Susensio/soft-starter/docs/photos/IMG_20240419_203253329.jpg

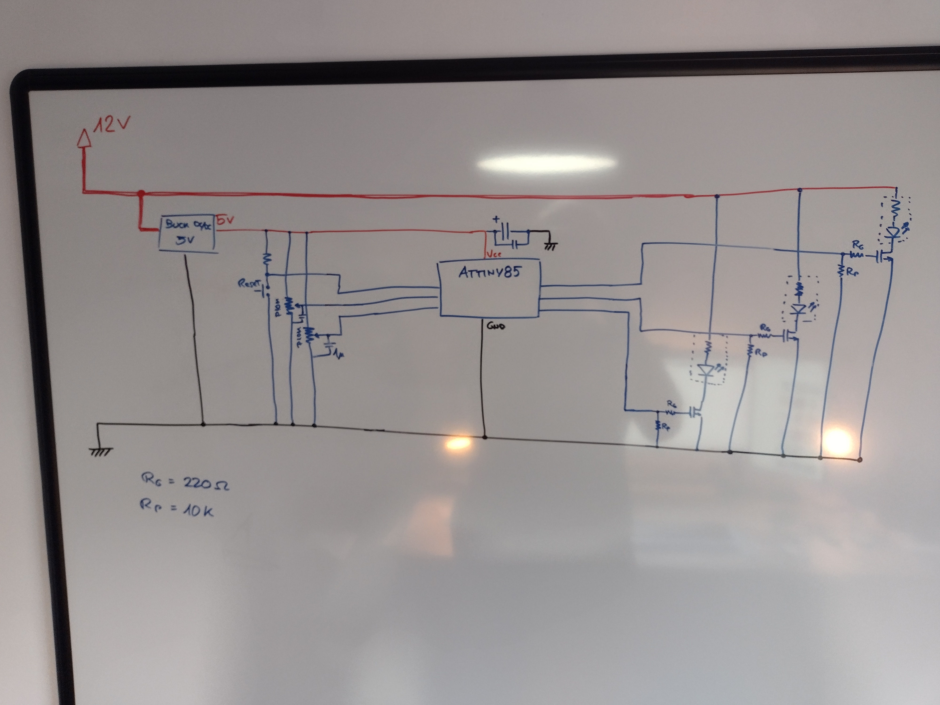
docs/photos/IMG_20240419_203253329.jpg
