Susensio/soft-starter/docs/photos/IMG_20240422_180927953.jpg

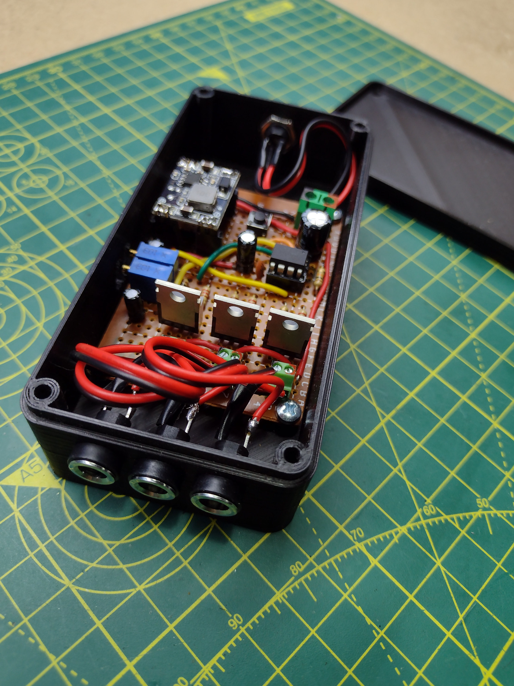
docs/photos/IMG_20240422_180927953.jpg
