Susensio/soft-starter/docs/photos/IMG_20240419_124029173.jpg

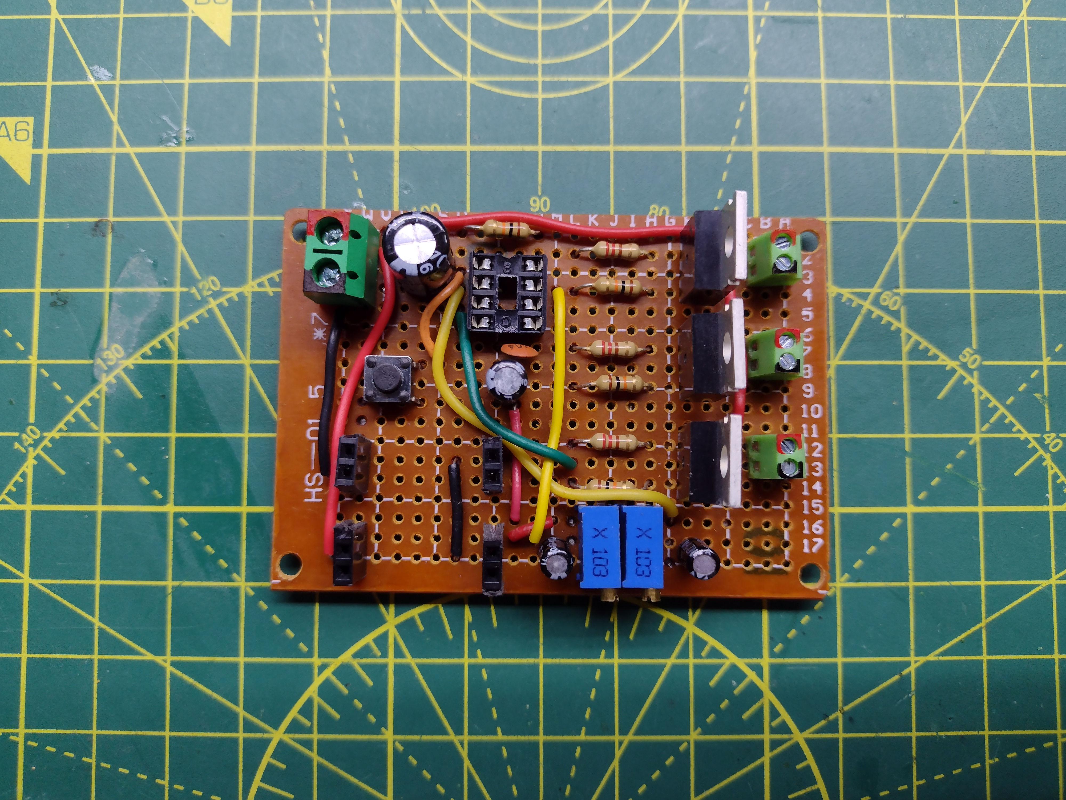
docs/photos/IMG_20240419_124029173.jpg
