Susensio/soft-starter/docs/photos/IMG_20240419_124034786.jpg

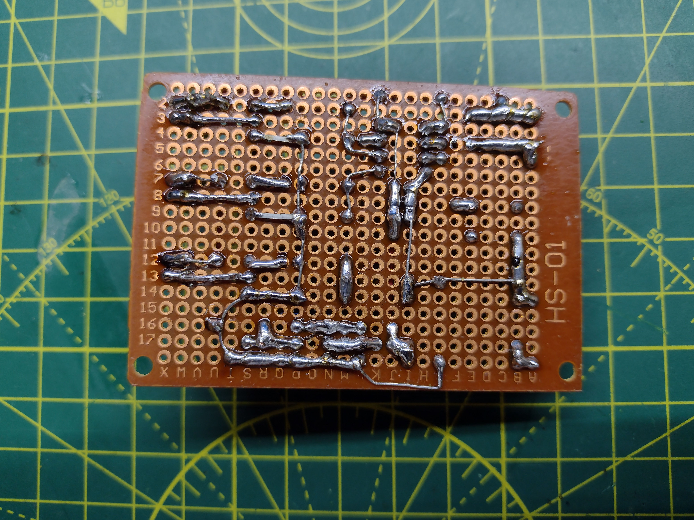
docs/photos/IMG_20240419_124034786.jpg
