Susensio/soft-starter/enclosure/soft_starter_box.stl

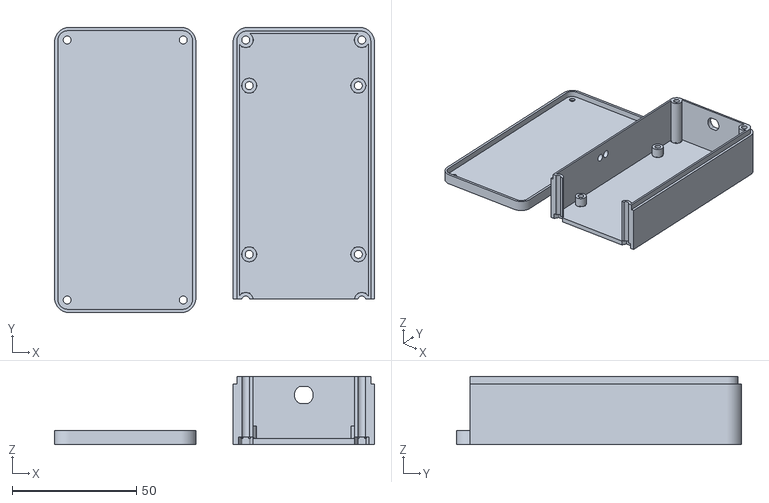
[picture p5: CAD file, 2024-04-25]
enclosure/soft_starter_box.stl
129.0 x 115.0 x 27.5
