Susensio/soft-starter/docs/schematics.pdf

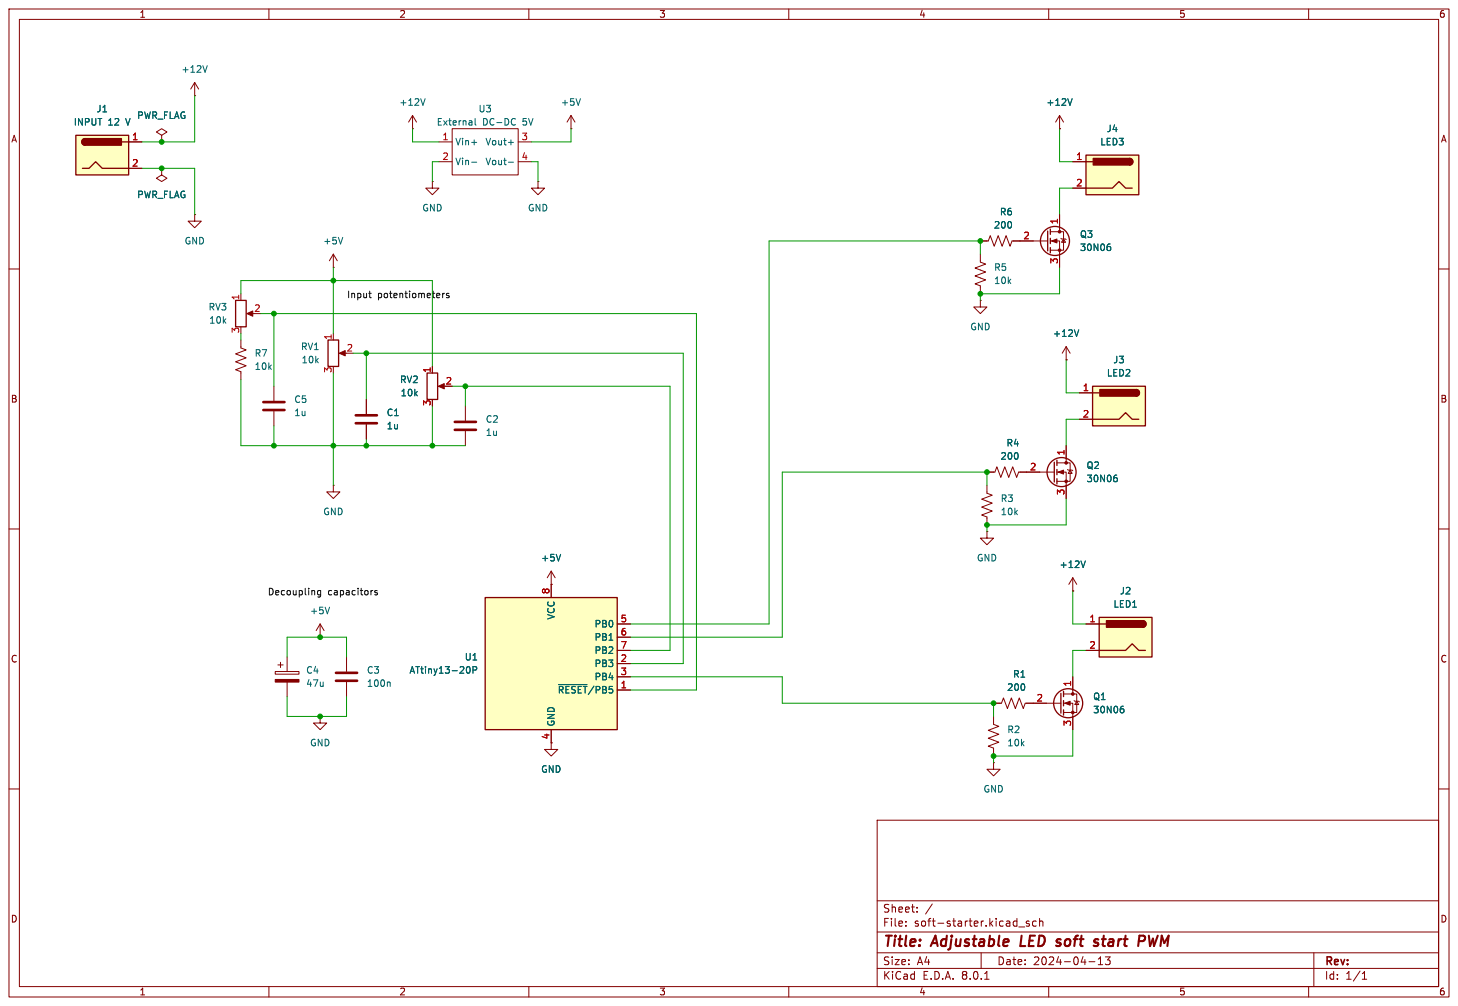
[picture p6: page 1]

Id: 1/1 Title: Adjustable LED soft start PWM
