Susensio/soft-starter/docs/perfboard.pdf

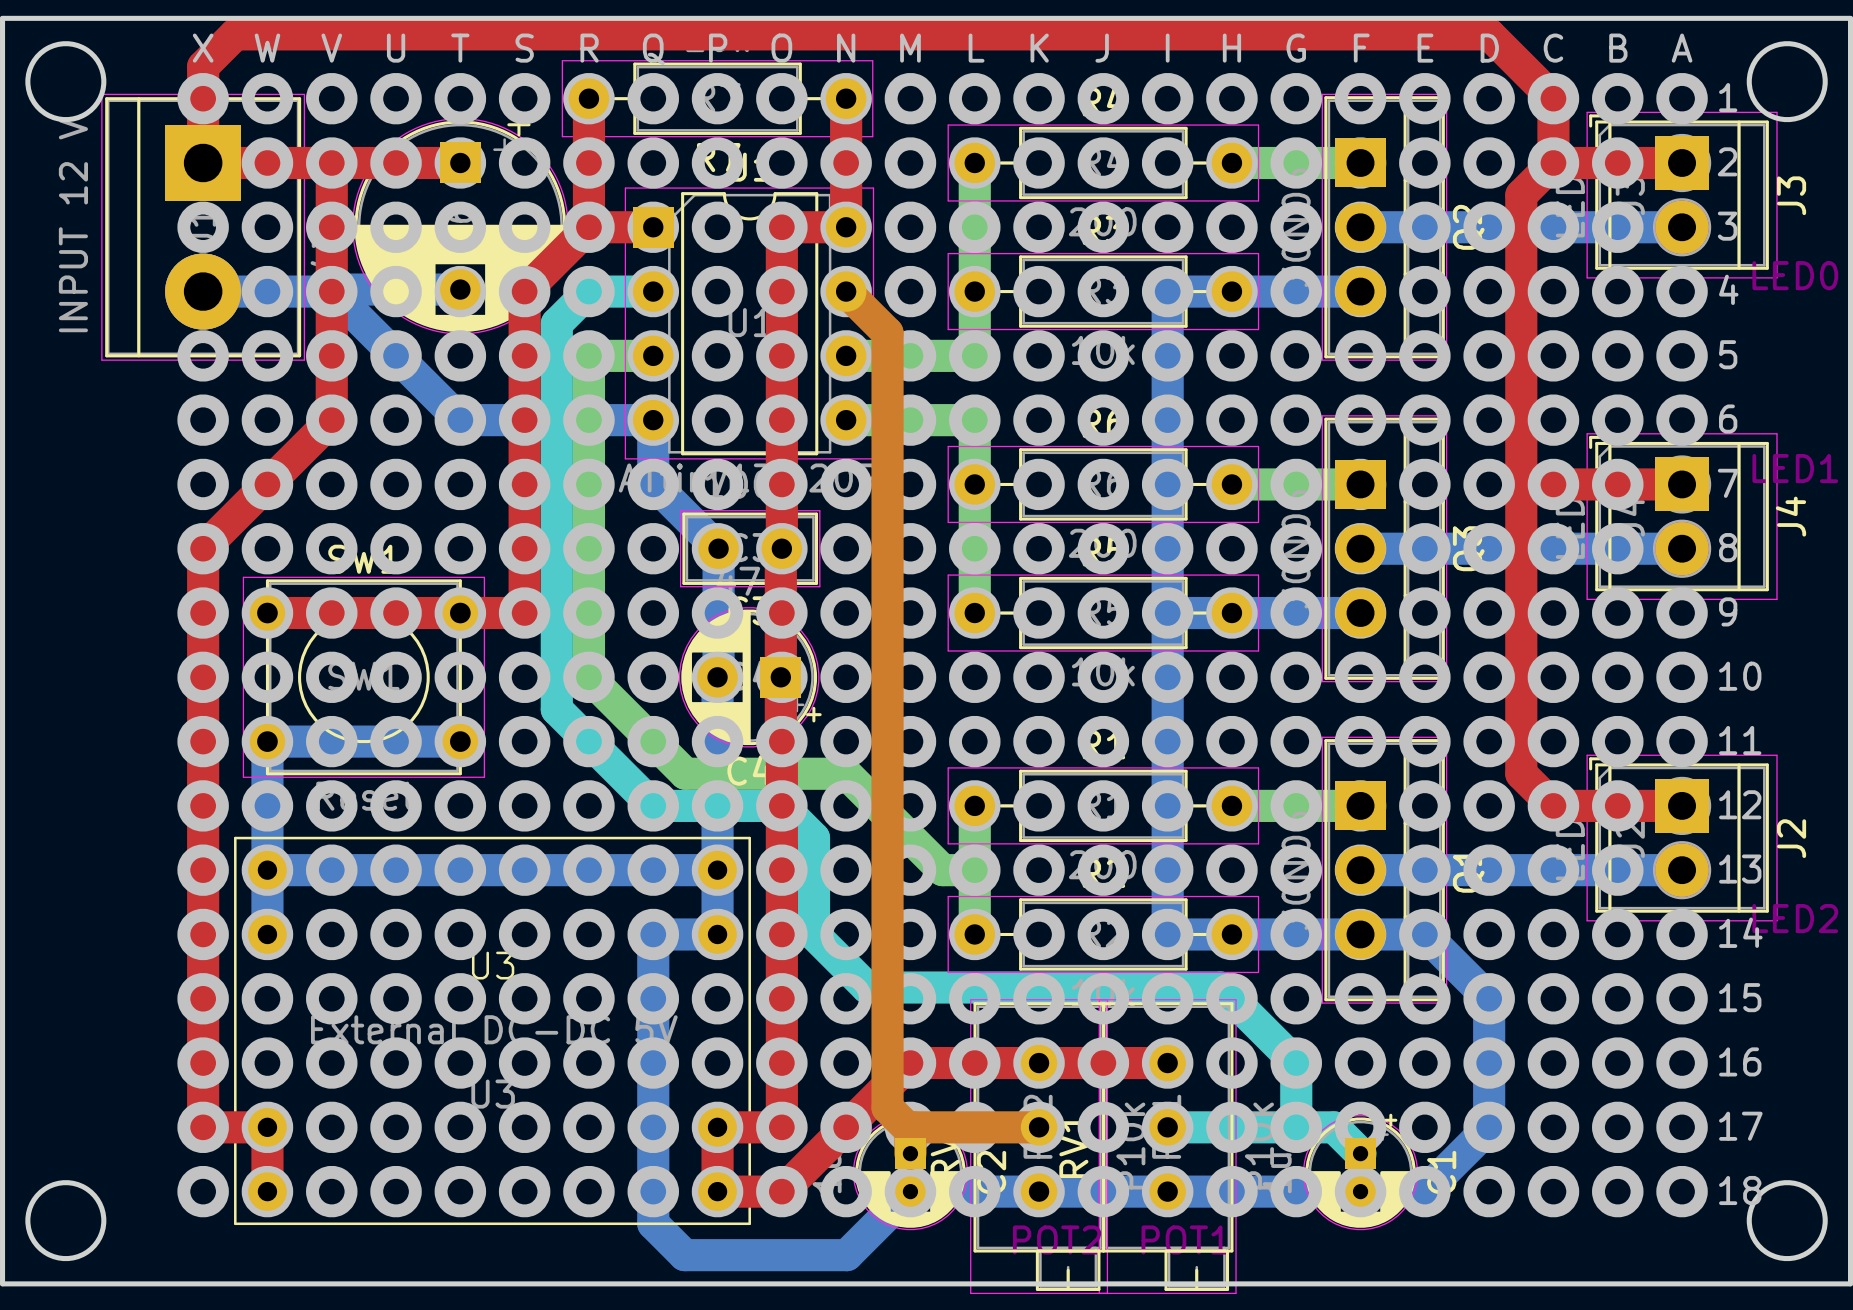
[picture p7: page 1]
