Susensio/soft-starter/schematics/soft-starter.kicad_pcb

## KiCad design schematics/soft-starter.kicad_pcb (2024-04-22)

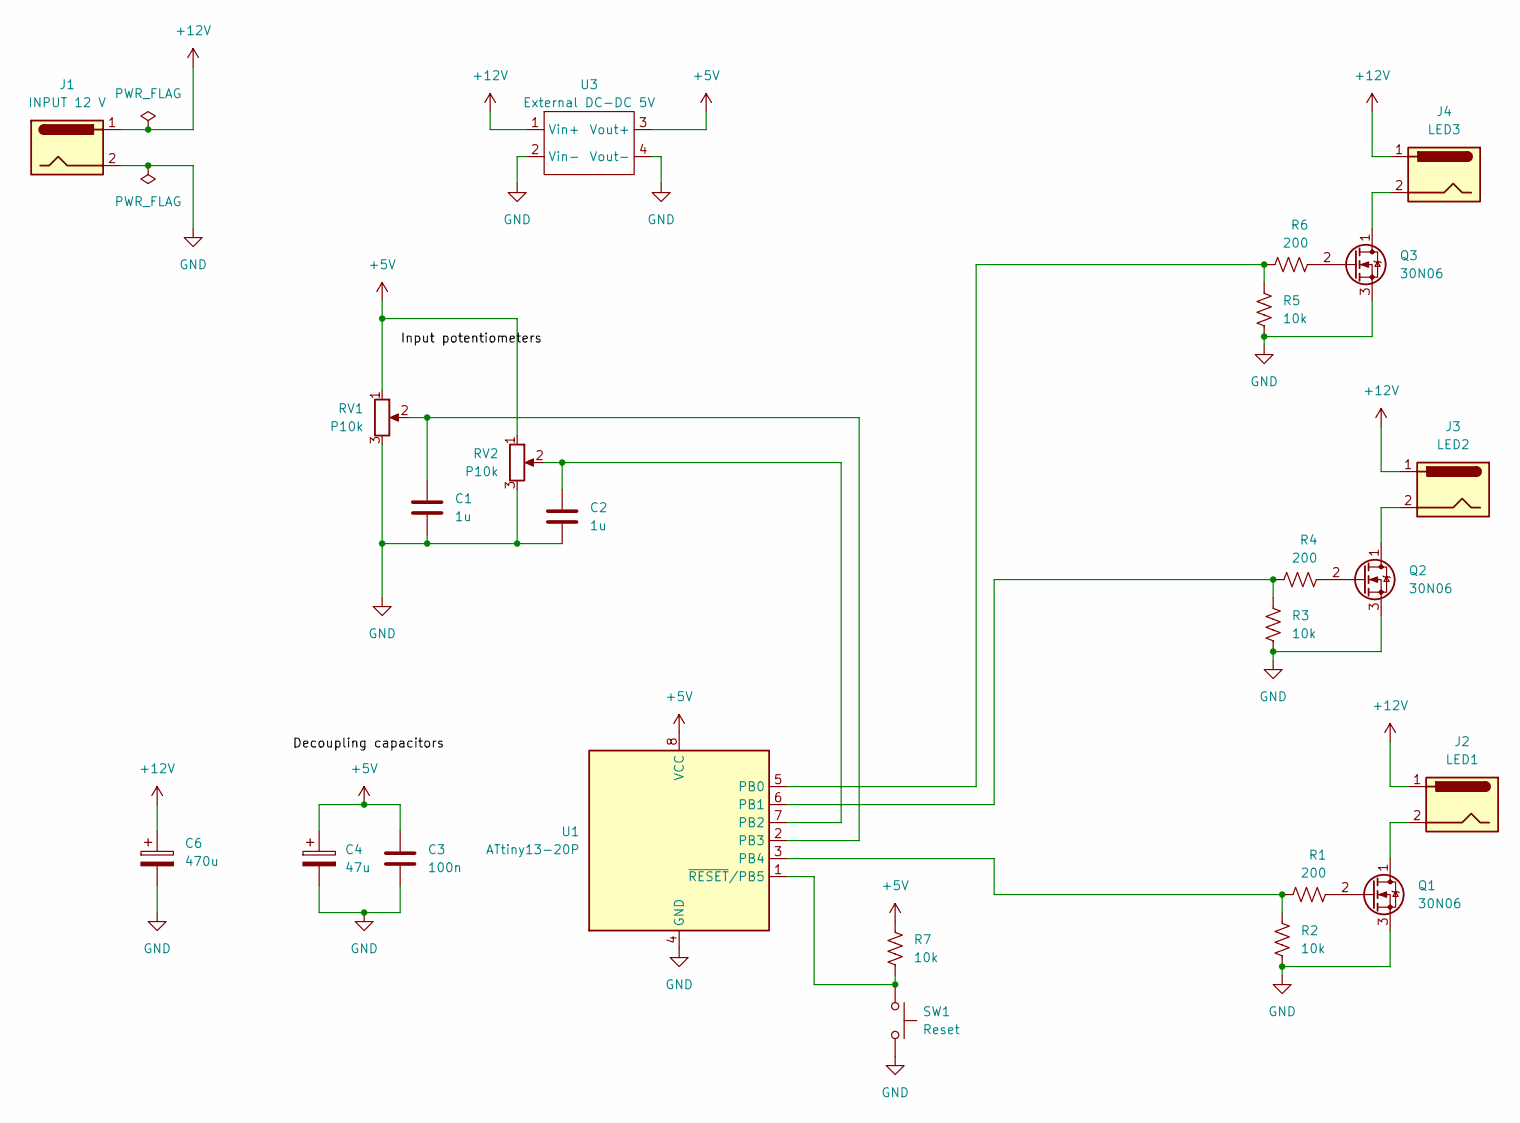
[picture p8: schematic soft-starter.kicad_sch, Adjustable LED soft start PWM]

Parts:
C1, C2: 1u; C_Radial_D4.0mm_H7.0mm_P1.50mm
C3: 100n; C_Disc_D5.0mm_W2.5mm_P2.50mm
C4: 47u; CP_Axial_L11.0mm_D5.0mm_P18.00mm_Horizontal
C6: 470u; CP_Radial_D8.0mm_P5.00mm
J1: INPUT 12 V; TerminalBlock_bornier-2_P5.08mm
J2: LED1; TerminalBlock_TE_282834-2_1x02_P2.54mm_Horizontal
J3: LED2; TerminalBlock_TE_282834-2_1x02_P2.54mm_Horizontal
J4: LED3; TerminalBlock_TE_282834-2_1x02_P2.54mm_Horizontal
Q1, Q2, Q3: 30N06; DirectFET_MD
R1, R4, R6: 200; R_Axial_DIN0207_L6.3mm_D2.5mm_P10.16mm_Horizontal
R2, R3, R5, R7: 10k; R_Axial_DIN0207_L6.3mm_D2.5mm_P10.16mm_Horizontal
RV1, RV2: P10k; Potentiometer_Bourns_3296X_Horizontal
SW1: Reset; SW_PUSH_6mm
U1: ATtiny13-20P; DIP-8_W7.62mm
U3: External DC-DC 5V; 5V 3A BUCK ALIEXPRESS

Connections:
+5V: C3.1, C4.1, R7.1, RV1.1, RV2.1, U1.8 (VCC), U3.3 (Vout+)
+12V: C6.1, J1.1, J2.1, J3.1, J4.1, U3.1 (Vin+)
GND: C1.2, C2.2, C3.2, C4.2, C6.2, J1.2, Q1.3 (S), Q2.3 (S), Q3.3 (S), R2.2, R3.2, R5.2, RV1.3, RV2.3, SW1.2, U1.4 (GND), U3.2 (Vin-), U3.4 (Vout-)
unnamed: J2.2, Q1.1 (D)
unnamed: Q1.2 (G), R1.2
unnamed: J3.2, Q2.1 (D)
unnamed: Q2.2 (G), R4.2
unnamed: J4.2, Q3.1 (D)
unnamed: Q3.2 (G), R6.2
unnamed: R5.1, R6.1, U1.5 (PB0)
unnamed: R3.1, R4.1, U1.6 (PB1)
unnamed: C2.1, RV2.2, U1.7 (PB2)
unnamed: C1.1, RV1.2, U1.2 (PB3)
unnamed: R1.1, R2.1, U1.3 (PB4)
unnamed: R7.2, SW1.1, U1.1 (~RESET/PB5)

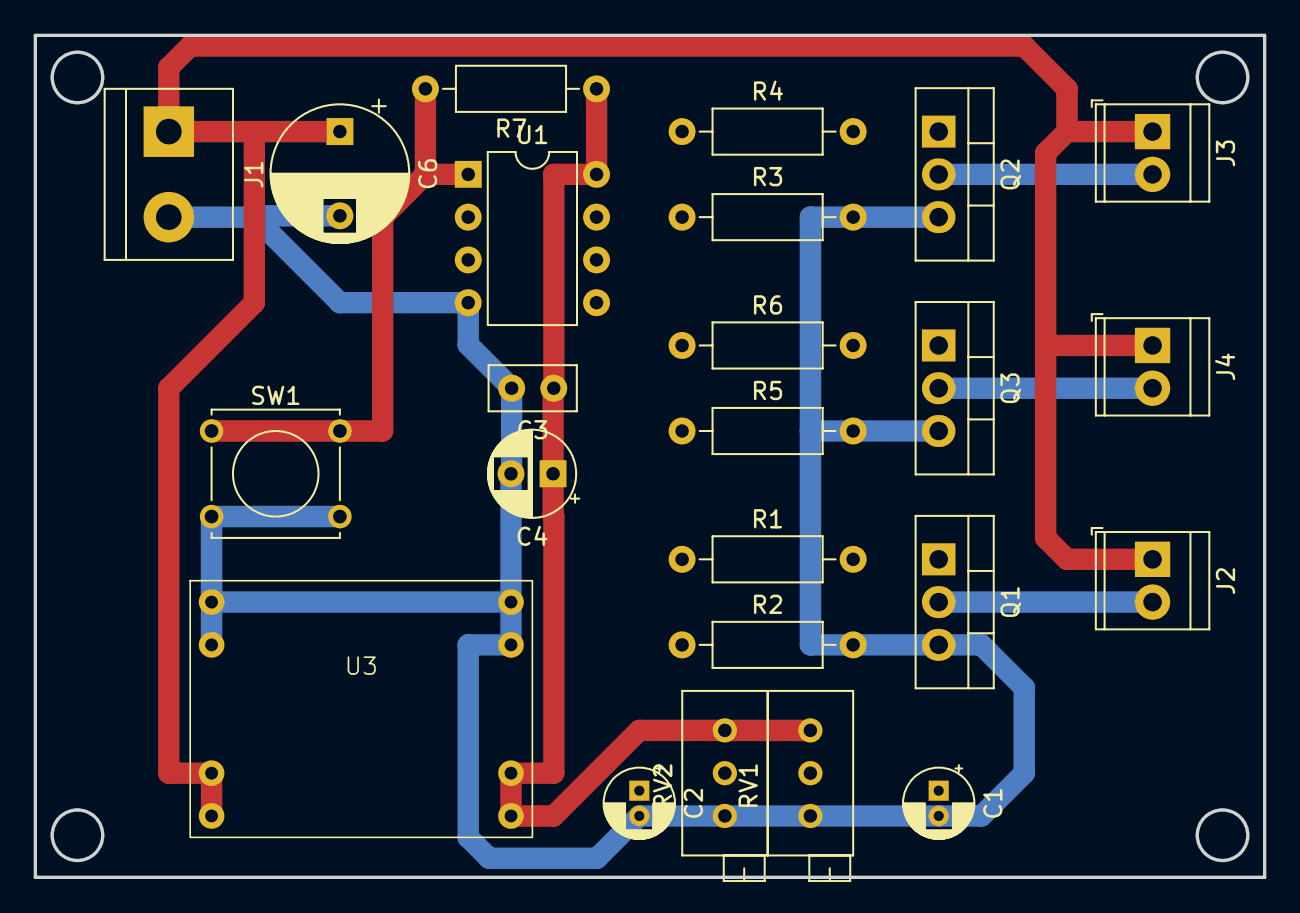
[picture p9: board soft-starter.kicad_pcb from above]

Board: 6 copper layers, 73.0 x 50.0 mm, 24 parts (0 on the bottom side), 15 nets.
