Susensio/soft-starter/(commit log)

2024-04-19 Add arduino code
2024-04-19 Add kicad schematics
    [soft-starter.kicad_pcb, soft-starter.kicad_sch]
2024-04-19 Add docs and printed schematics
    [bom.csv]
2024-04-22 Update pcb to actual thing
    [soft-starter.kicad_pcb]
2024-04-25 Add enclosure 3d print layout
    [generic_box.scad, soft_starter_box.stl]
